msherman13/bixi/misc/bixi_pic2.JPG

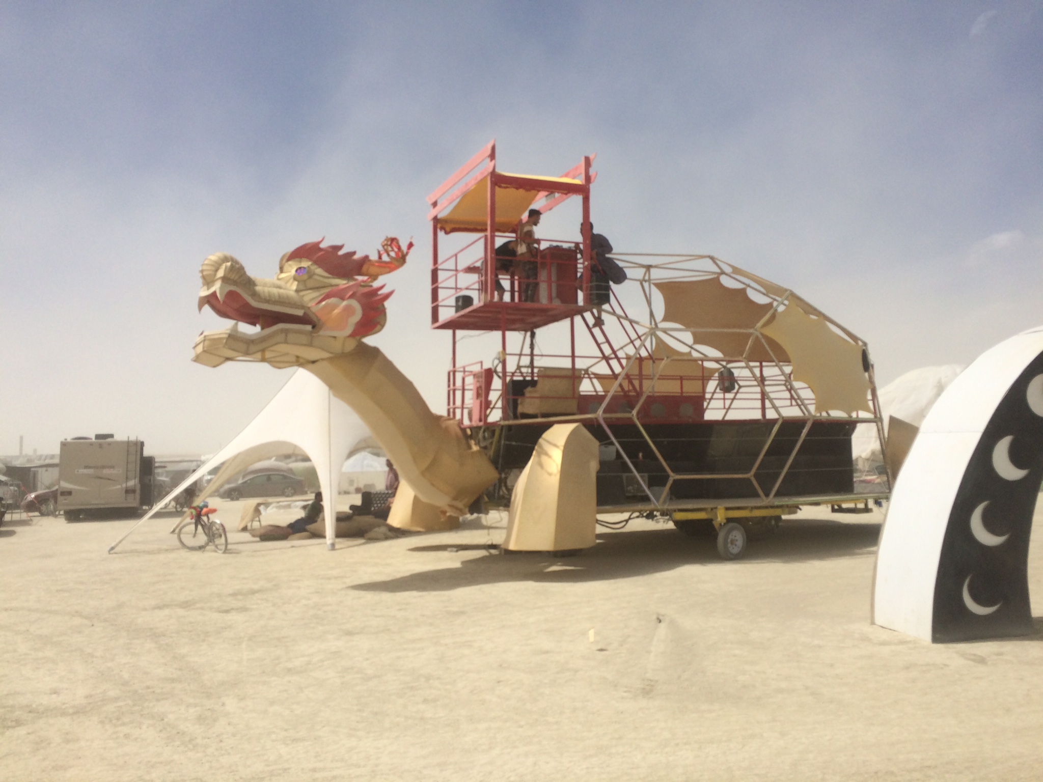
misc/bixi_pic2.JPG
