msherman13/bixi/misc/dimensions2.jpeg

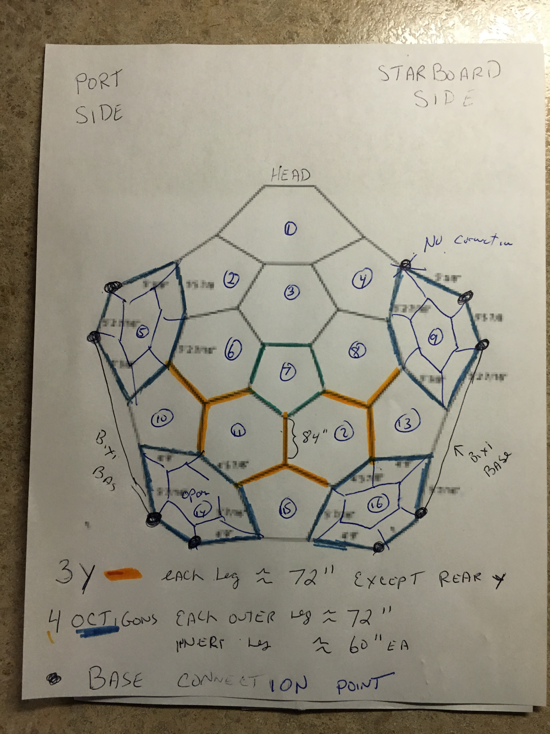
misc/dimensions2.jpeg
