msherman13/bixi/misc/bixi_dome_data_map.pdf

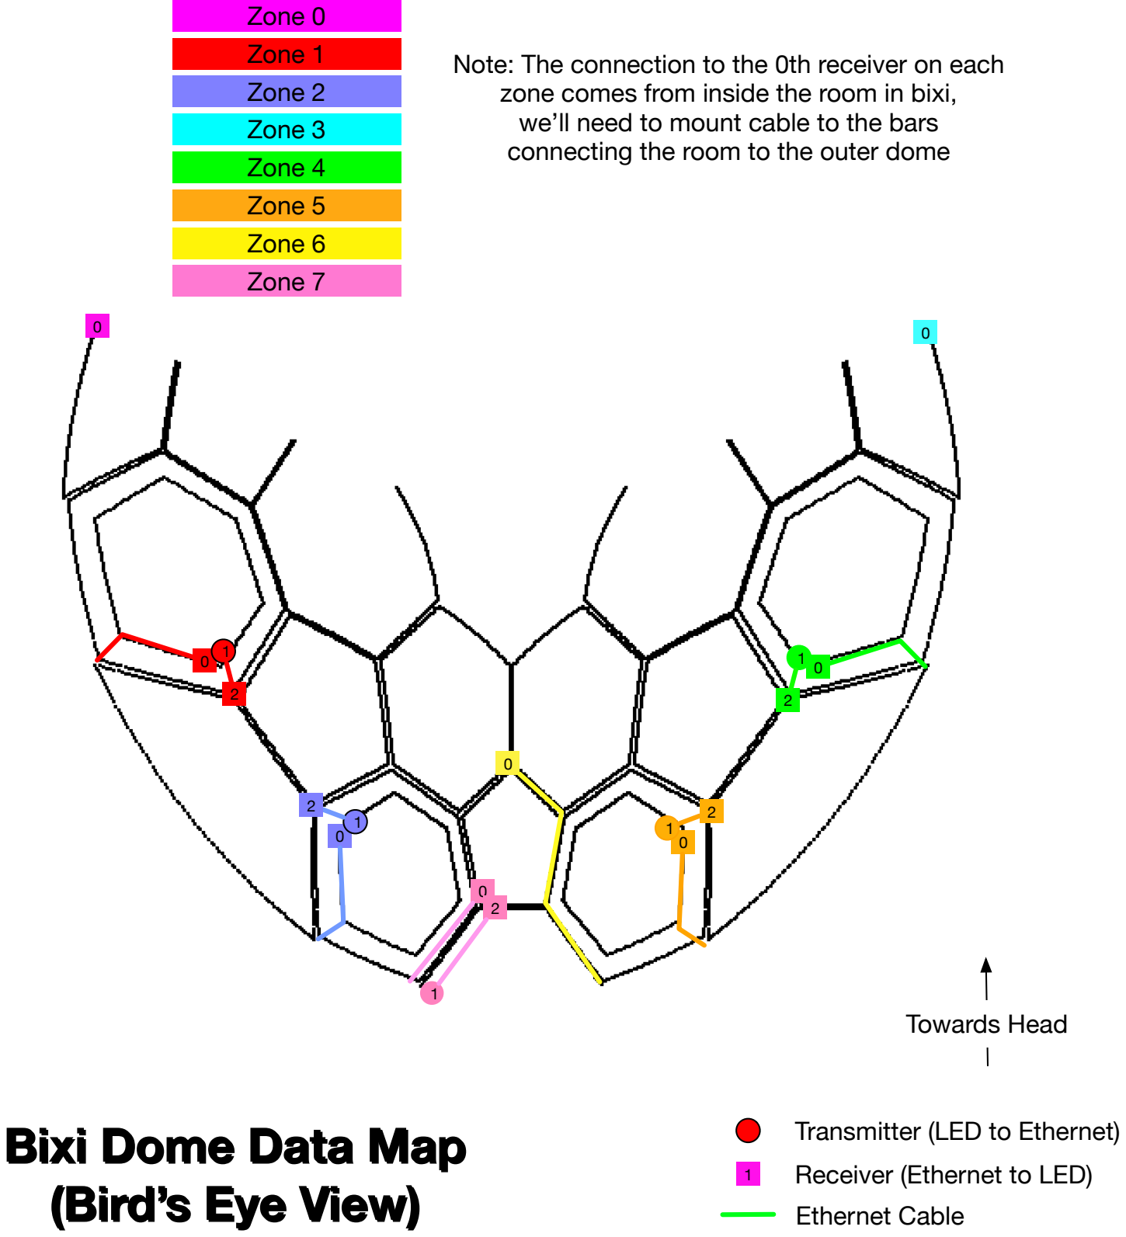
[picture p3: page 1]

Towards Head

Zone 0

1 Receiver (Ethernet to LED) Ethernet Cable

0

0

Note: The connection to the 0th receiver on each zone comes from inside the room in bixi, we’ll need to mount cable to the bars connecting the room to the outer dome

1

Transmitter (LED to Ethernet)

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
Zone 1
Zone 2
Zone 3
Zone 4
Zone 5
Zone 6
Zone 7

# Bixi Dome Data Map (Bird’s Eye View)

# Bixi Dome Data Map (Bird’s Eye View)
