msherman13/bixi/misc/bixi_dome_power_map.pdf

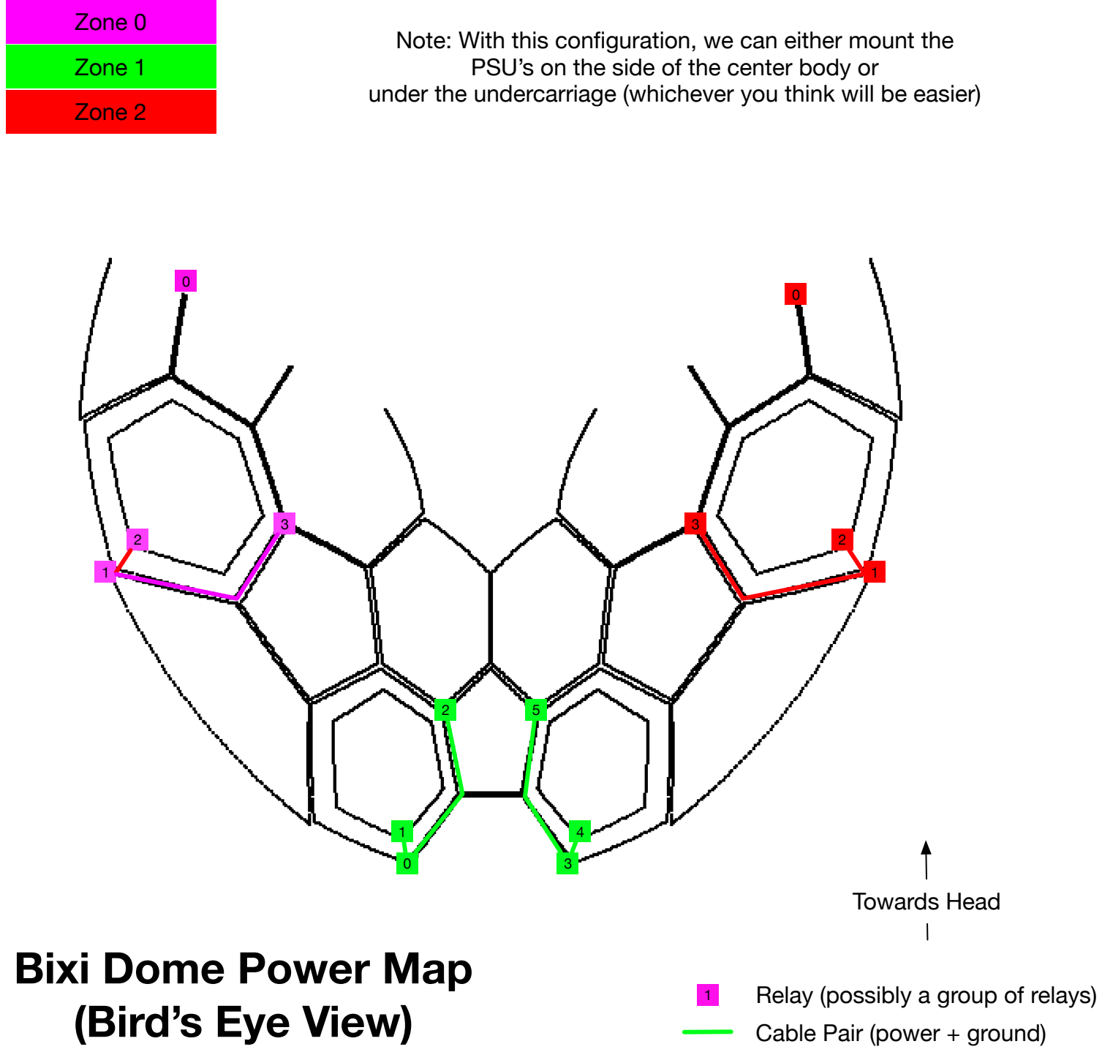
[picture p4: page 1]

Towards Head

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
Zone 0
Zone 1
Zone 2

Note: With this configuration, we can either mount the PSU’s on the side of the center body or under the undercarriage (whichever you think will be easier)

1 Relay (possibly a group of relays) Cable Pair (power + ground)

# Bixi Dome Power Map (Bird’s Eye View)
