msherman13/bixi/misc/bixi_dome_shape_map.pdf

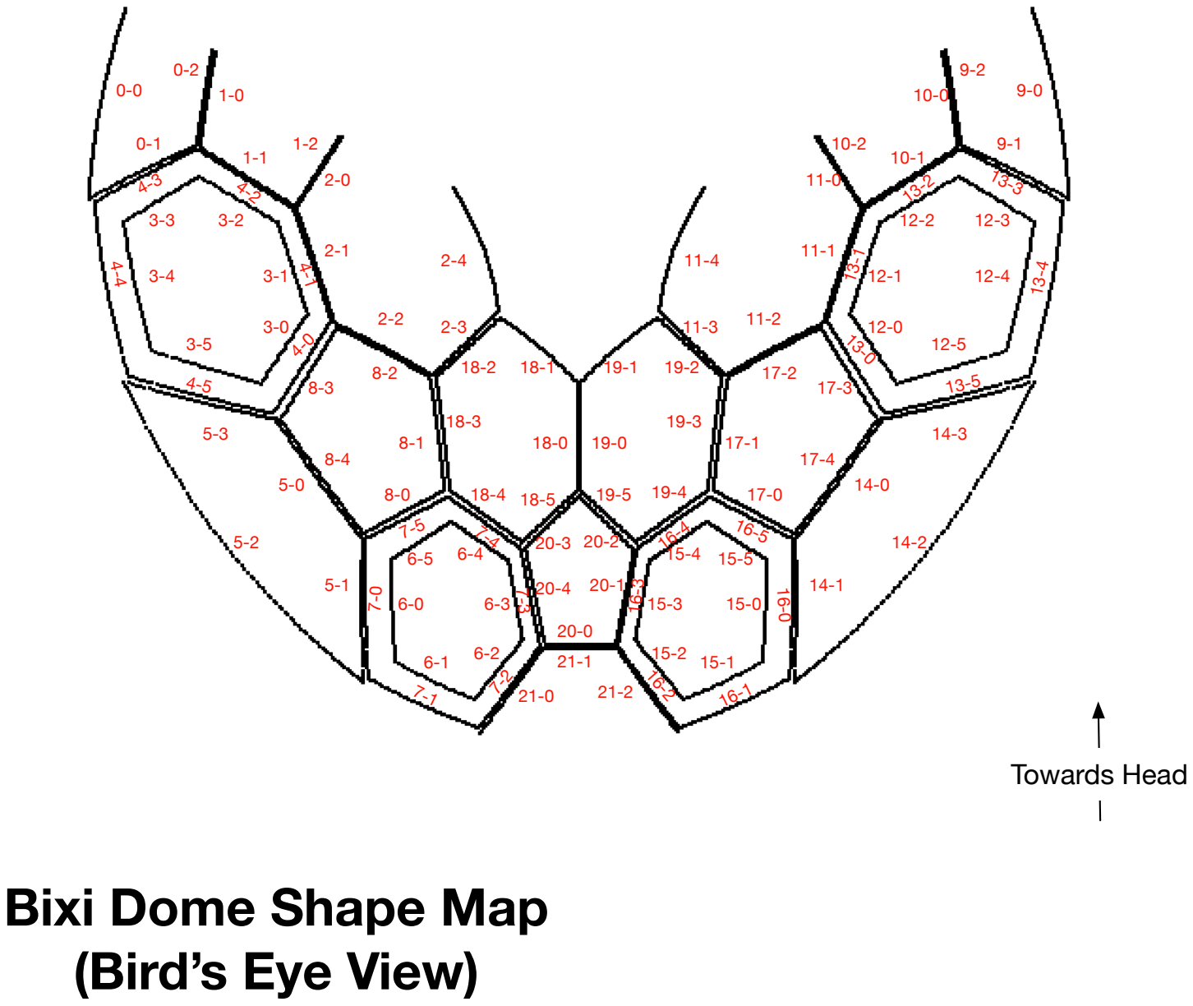
[picture p5: page 1]

## Towards Head

# Bixi Dome Shape Map (Bird’s Eye View)

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
2-2 2-3 2-4

3-0

3-1

3-3 3-2

3-4

3-5 | 4-0 4-1

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
6-1 6-2 6-3

6-4 6-5

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
10-0

10-1

10-2

11-0

11-1

11-2 11-3

11-4

12-0

12-1

12-2 | 12-3
| 12-4

12-5 13-0

13-1

13-2

13-3

13-4

13-5

14-0

14-1

14-2

14-3

15-0

15-1 15-2

15-3

15-4 15-5

16-0

16-1

16-2

16-3

16-4

16-5

17-0

17-1

17-2
17-3

17-4

18-0

18-2 18-1

18-3

18-4 18-5

19-0

19-1 | 19-2
| 19-3

19-5 19-4

20-0

20-1

20-3 20-2

20-4

21-0

21-1
21-2
