msherman13/bixi/misc/bixi_dome_shape_map.graffle/image2.png

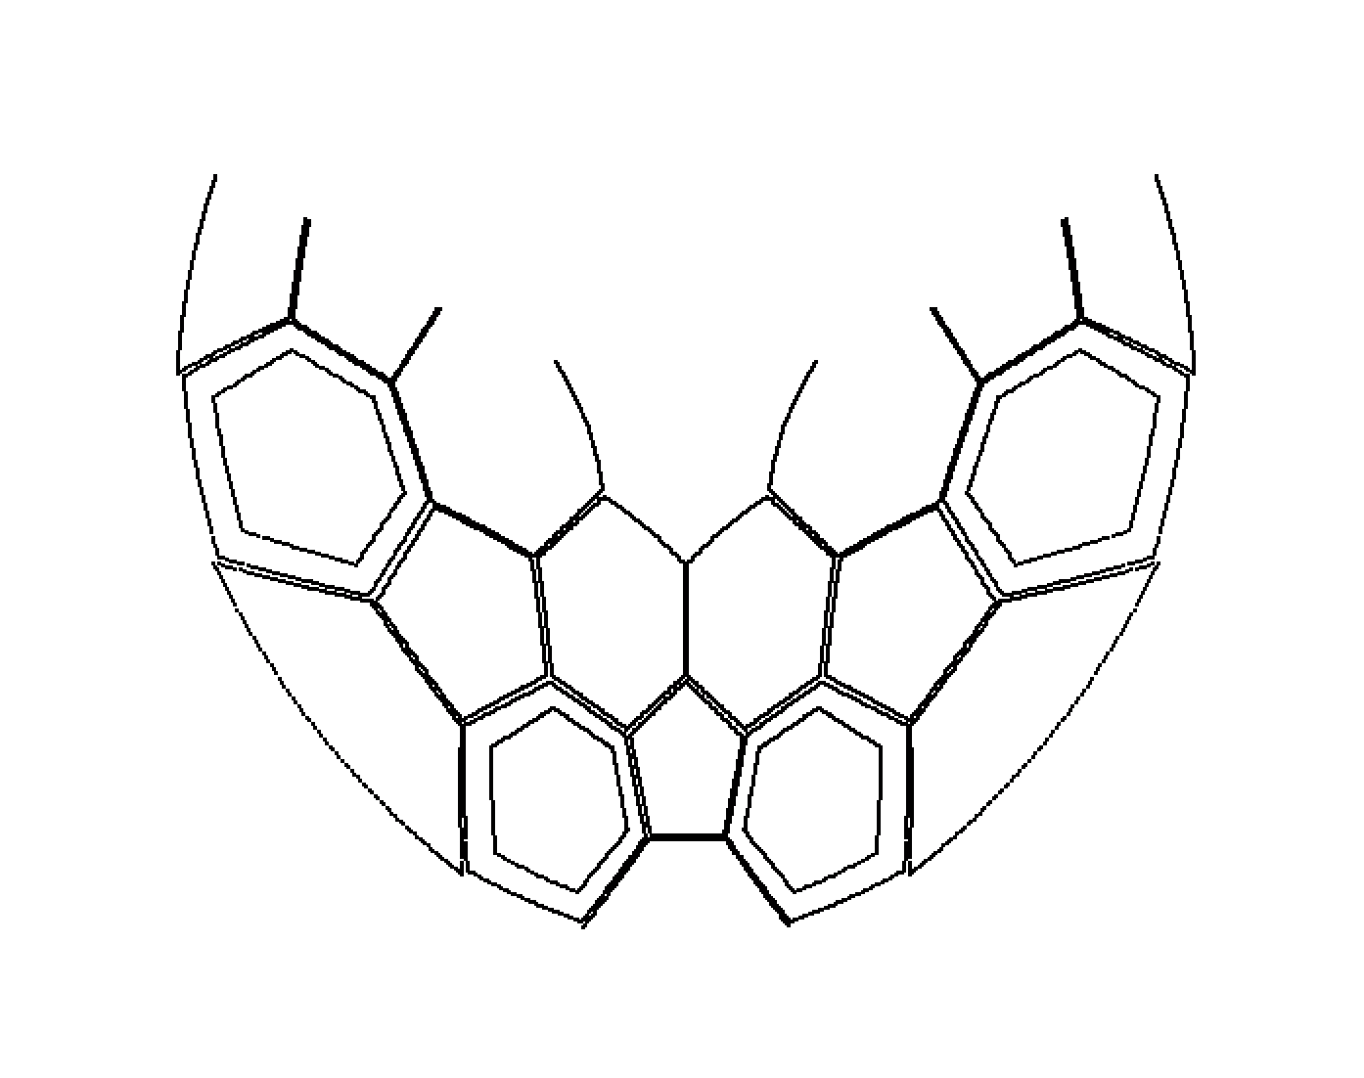
misc/bixi_dome_shape_map.graffle/image2.png
