msherman13/bixi/misc/bixi_led_indices.png

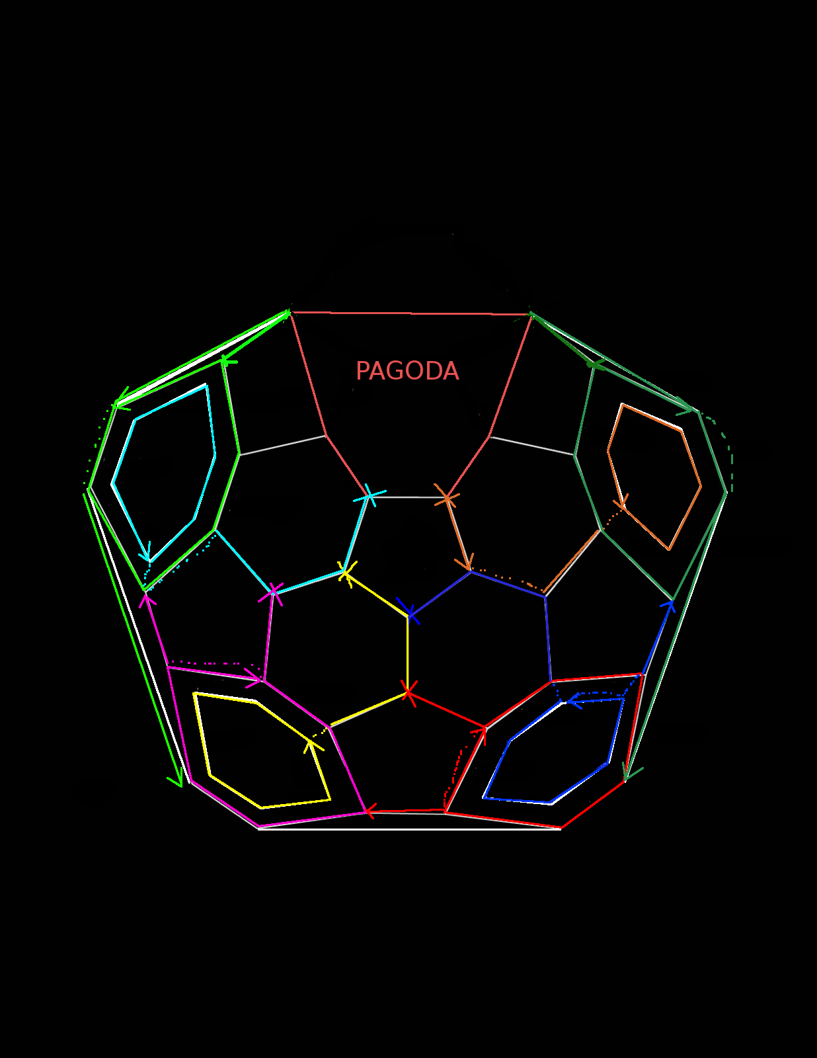
misc/bixi_led_indices.png
