msherman13/bixi/misc/bixi_outline.jpeg

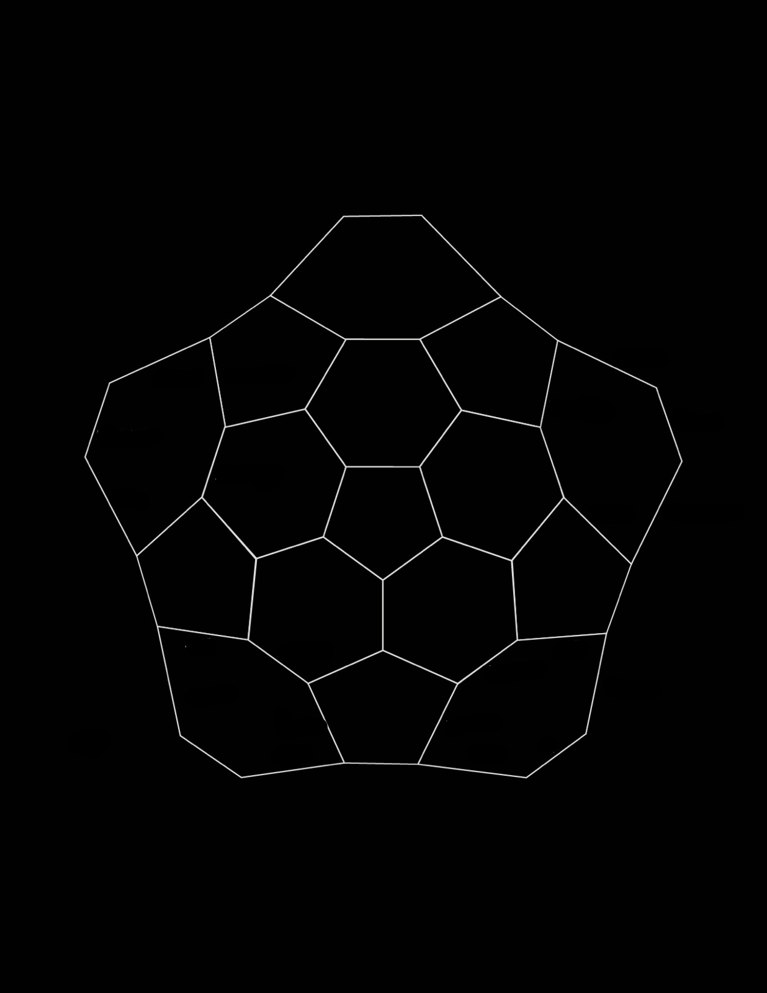
misc/bixi_outline.jpeg
