msherman13/bixi/misc/bixi_pic1.JPG

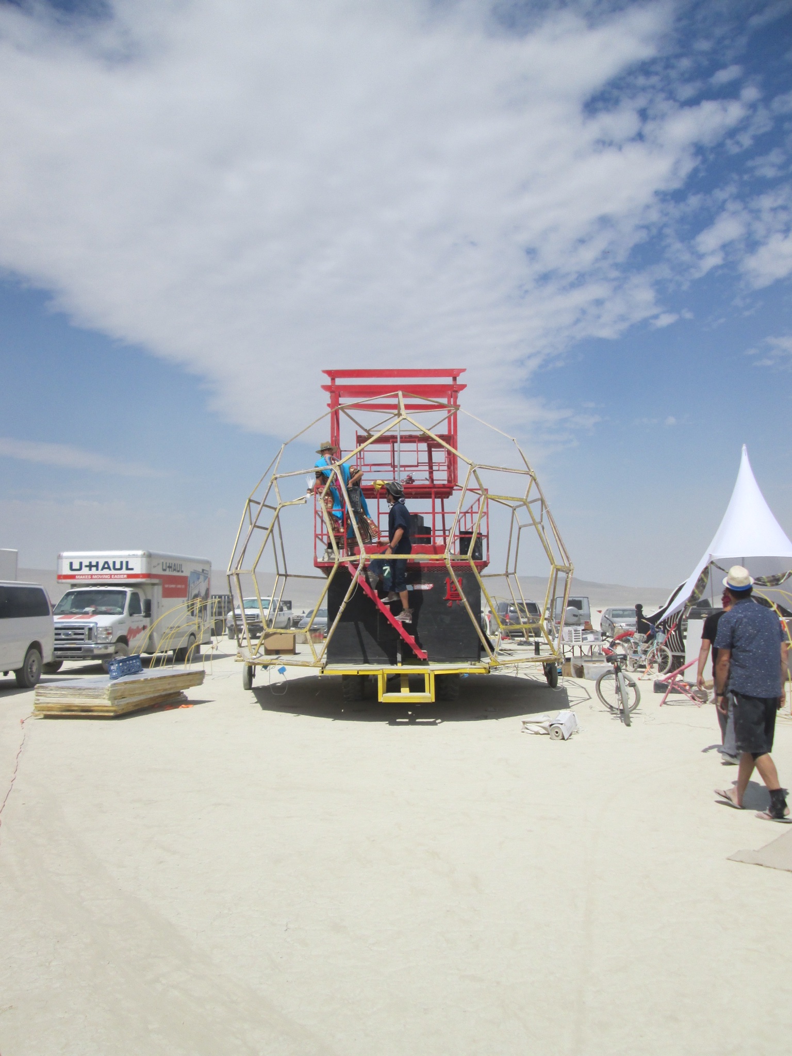
misc/bixi_pic1.JPG
