msherman13/bixi/misc/inventory.xlsx

Table 1
Item | Requirement | On Hand | At Jon’s | At Chris’s | Needed
LED’s | 450 | 300 | 0 | 150 | 0
Power Relay | 60 | 58 | 0 | 0 | 2
Power Relay Enclosure | 60 | 40 | 25 | 0 | -5
Receivers | 29 | 50 | 0 | 0 | -21
Transmitters | 5 | 10 | 0 | 0 | -5
Data Relay Enclosures | 34 | 80 | 0 | 0 | -46
Controllers | 3 | 6 | 0 | 0 | -3
Controller Enclosures | 3 | 1 | 2 | 0 | 0
PSU | 6 | 3 | 3 | 0 | 0
DC Power Cable | 300 | 50 | 250 | 0 | 0
AC Power Cable | 6 | 6 | 0 | 0 | 0
Controller PSU | 3 | 0 | 3 | 0 | 0
50ft Ethernet Cable | 24 | 8 | 16 | 0 | 0
18in Ethernet Cable | 4 | 8 | 0 | 0 | -4
5ft ethernet cable | 1 | 0 | 5 | 0 | -4
Power Relay Screws | 120 | 80 | 0 | 0 | 40
Power Strip | 2 | 0 | 0 | 0 | 2
