msherman13/bixi/(list of files, drawings)

Other design files:
kicad/bixi.dsn
kicad/bixi_node/bixi_node.dsn
kicad/sn75lbc175n_breakout/sn75lbc175n_breakout.dsn
