msherman13/bixi/kicad/bixi_node/bixi_node.kicad_pcb

## KiCad design kicad/bixi_node/bixi_node.kicad_pcb (2017-06-03)

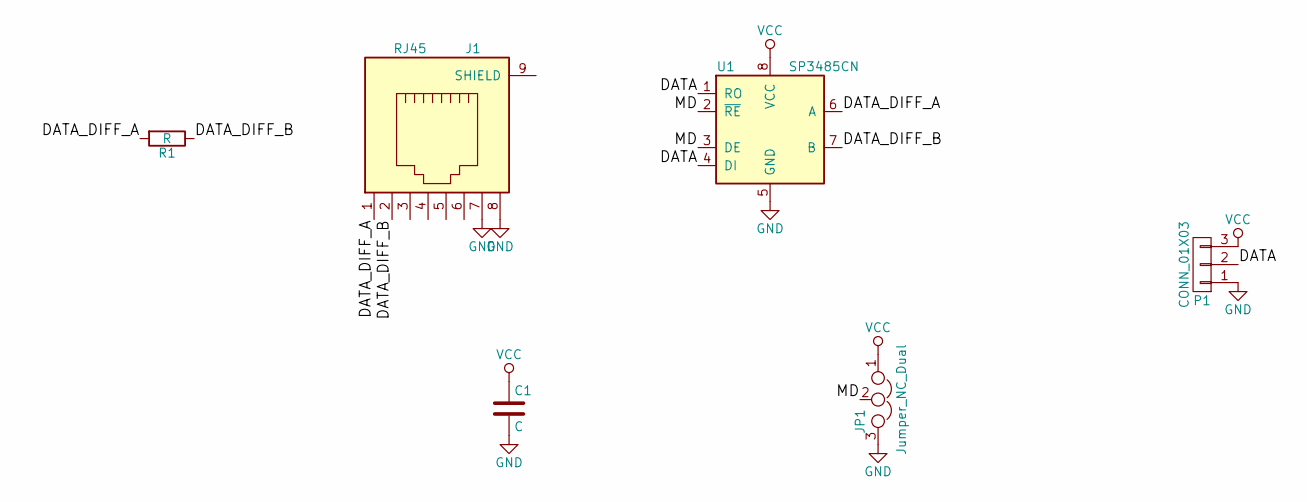
[picture p10: schematic bixi_node.sch]

Parts:
C1: C; C_Axial_L3.8mm_D2.6mm_P7.50mm_Horizontal
J1: RJ45; RJ45_8
JP1: Jumper_NC_Dual; jumper_3_pin_fixed
P1: CONN_01X03; 3-wire-hole-with-relief
R1: R; Resistor_Horizontal_RM7mm
U1: SP3485CN; DIP-8_W7.62mm

Connections:
/DATA: P1.2, U1.1 (RO), U1.4 (DI)
/DATA_DIFF_A: J1.1, R1.2, U1.6 (A)
/DATA_DIFF_B: J1.2, R1.1, U1.7 (B)
/MD: JP1.2, U1.2 (~RE~), U1.3 (DE)
GND: C1.2, J1.7, J1.8, JP1.3, P1.1, U1.5 (GND)
VCC: C1.1, JP1.1, P1.3, U1.8 (VCC)

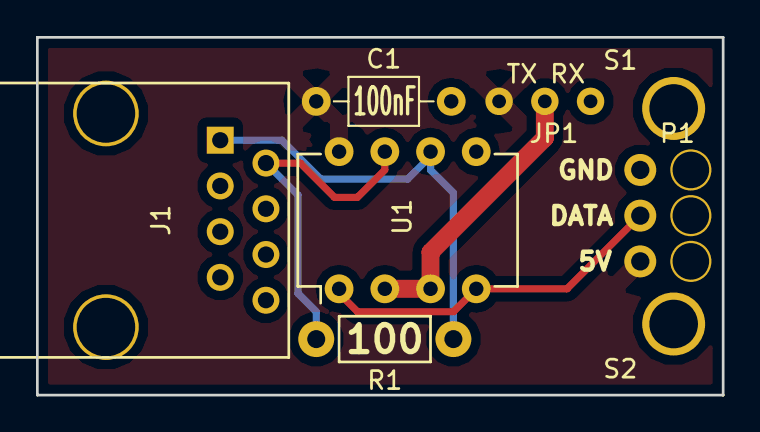
[picture p11: board bixi_node.kicad_pcb from above]

Board: 2 copper layers, 38.1 x 19.9 mm, 8 parts (0 on the bottom side), 6 nets.

Other parts of the board:
S1, S2: MountingHole_2.7mm_Pad
