msherman13/bixi/kicad/bixi_pt/bixi_pt.kicad_pcb

## KiCad design kicad/bixi_pt/bixi_pt.kicad_pcb (2017-05-24)

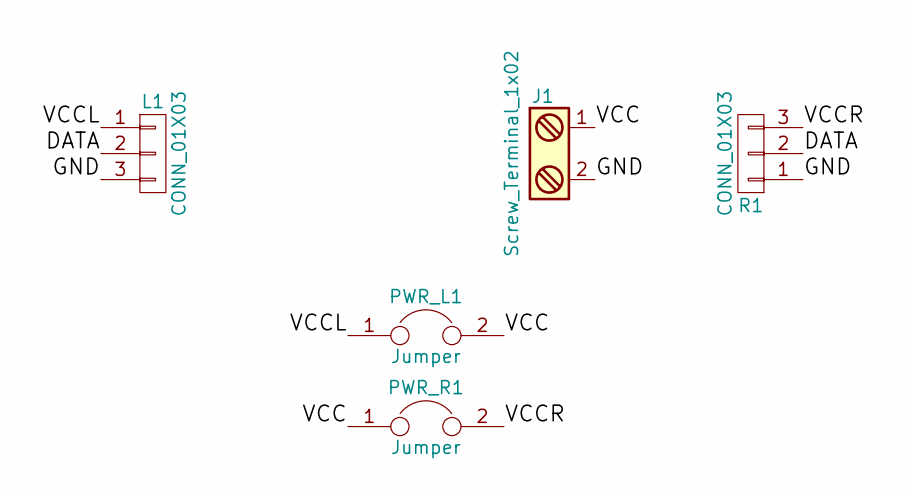
[picture p12: schematic bixi_pt.sch]

Parts:
J1: Screw_Terminal_1x02; OSTYK42102030-2P-Terminal
L1: CONN_01X03; 3-wire-hole-with-relief
PWR_L1: Jumper; Pin_Header_Straight_1x02_Pitch2.54mm
PWR_R1: Jumper; Pin_Header_Straight_1x02_Pitch2.54mm
R1: CONN_01X03; 3-wire-hole-with-relief

Connections:
/DATA: L1.2, R1.2
/GND: J1.2, L1.3, R1.1
/VCC: J1.1, PWR_L1.2, PWR_R1.1
/VCCL: L1.1, PWR_L1.1
/VCCR: PWR_R1.2, R1.3

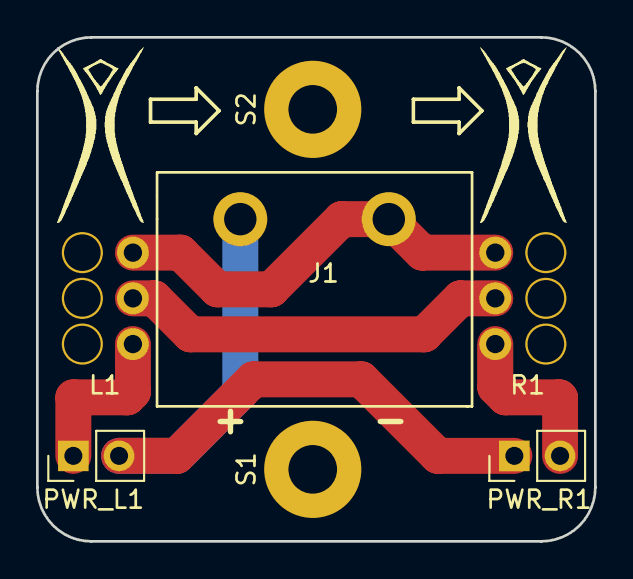
[picture p13: board bixi_pt.kicad_pcb from above]

Board: 2 copper layers, 31.0 x 28.0 mm, 9 parts (0 on the bottom side), 5 nets.

Other parts of the board:
S1, S2: MountingHole_3.5mm; MountingHole_2.7mm_Pad
burner-logo: burner-logo-fs
burner-logo#2: burner-logo-fs
