msherman13/bixi/kicad/sn75lbc175n_breakout/sn75lbc175n_breakout.kicad_pcb

## KiCad design kicad/sn75lbc175n_breakout/sn75lbc175n_breakout.kicad_pcb (2017-05-02)

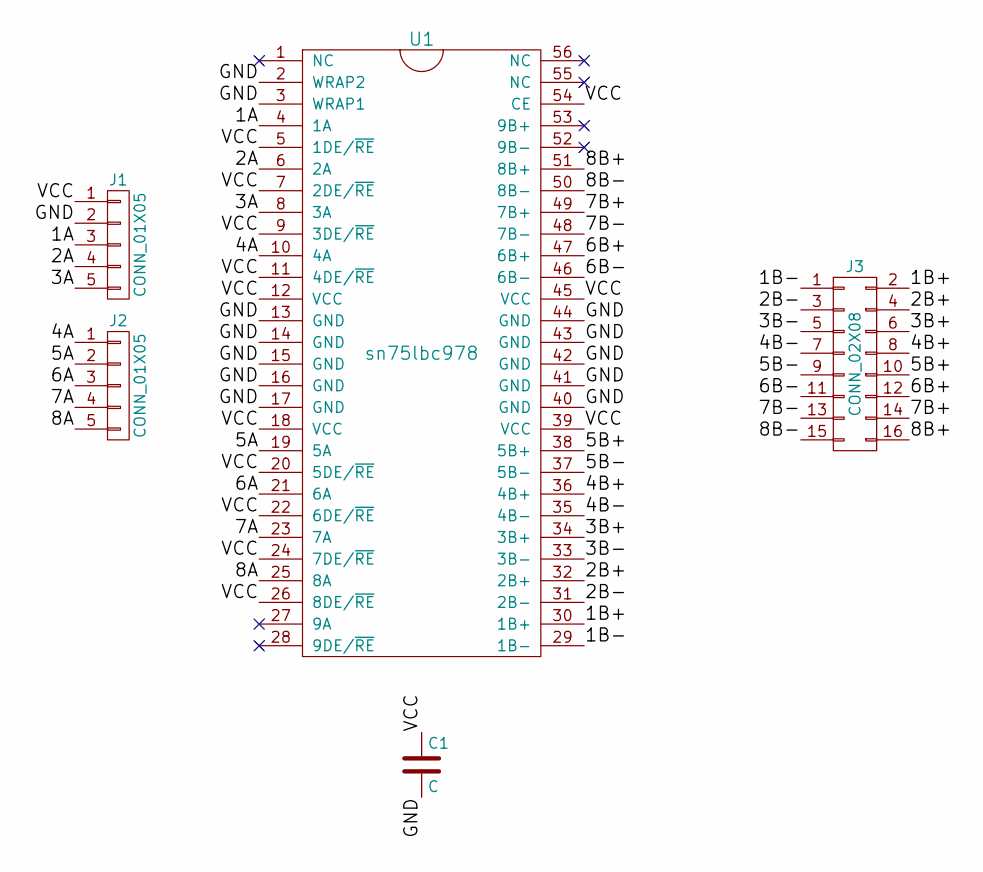
[picture p14: schematic sn75lbc175n_breakout.sch]

Parts:
C1: C; C_Disc_D4.7mm_W2.5mm_P5.00mm
J1, J2: CONN_01X05; Pin_Header_Straight_1x05_Pitch2.54mm
J3: CONN_02X08; Pin_Header_Straight_2x08_Pitch2.54mm
U1: sn75lbc978; SSOP-56_7.5x18.5mm_Pitch0.635mm

Connections:
/1A: J1.3, U1.4 (1A)
/1B+: J3.2, U1.30 (1B+)
/1B-: J3.1, U1.29 (1B-)
/2A: J1.4, U1.6 (2A)
/2B+: J3.4, U1.32 (2B+)
/2B-: J3.3, U1.31 (2B-)
/3A: J1.5, U1.8 (3A)
/3B+: J3.6, U1.34 (3B+)
/3B-: J3.5, U1.33 (3B-)
/4A: J2.1, U1.10 (4A)
/4B+: J3.8, U1.36 (4B+)
/4B-: J3.7, U1.35 (4B-)
/5A: J2.2, U1.19 (5A)
/5B+: J3.10, U1.38 (5B+)
/5B-: J3.9, U1.37 (5B-)
/6A: J2.3, U1.21 (6A)
/6B+: J3.12, U1.47 (6B+)
/6B-: J3.11, U1.46 (6B-)
/7A: J2.4, U1.23 (7A)
/7B+: J3.14, U1.49 (7B+)
/7B-: J3.13, U1.48 (7B-)
/8A: J2.5, U1.25 (8A)
/8B+: J3.16, U1.51 (8B+)
/8B-: J3.15, U1.50 (8B-)
/GND: C1.2, J1.2, U1.2 (WRAP2), U1.3 (WRAP1), U1.13 (GND), U1.14 (GND), U1.15 (GND), U1.16 (GND), U1.17 (GND), U1.40 (GND), U1.41 (GND), U1.42 (GND), U1.43 (GND), U1.44 (GND)
/VCC: C1.1, J1.1, U1.5 (1DE/~RE), U1.7 (2DE/~RE), U1.9 (3DE/~RE), U1.11 (4DE/~RE), U1.12 (VCC), U1.18 (VCC), U1.20 (5DE/~RE), U1.22 (6DE/~RE), U1.24 (7DE/~RE), U1.26 (8DE/~RE), U1.39 (VCC), U1.45 (VCC), U1.54 (CE)

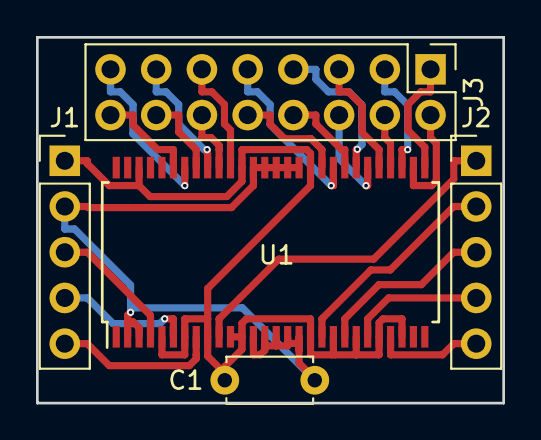
[picture p15: board sn75lbc175n_breakout.kicad_pcb from above]

Board: 2 copper layers, 25.9 x 20.3 mm, 5 parts (0 on the bottom side), 26 nets.
