msherman13/bixi/kicad/bixi.kicad_pcb

## KiCad design kicad/bixi.kicad_pcb (2017-04-09)

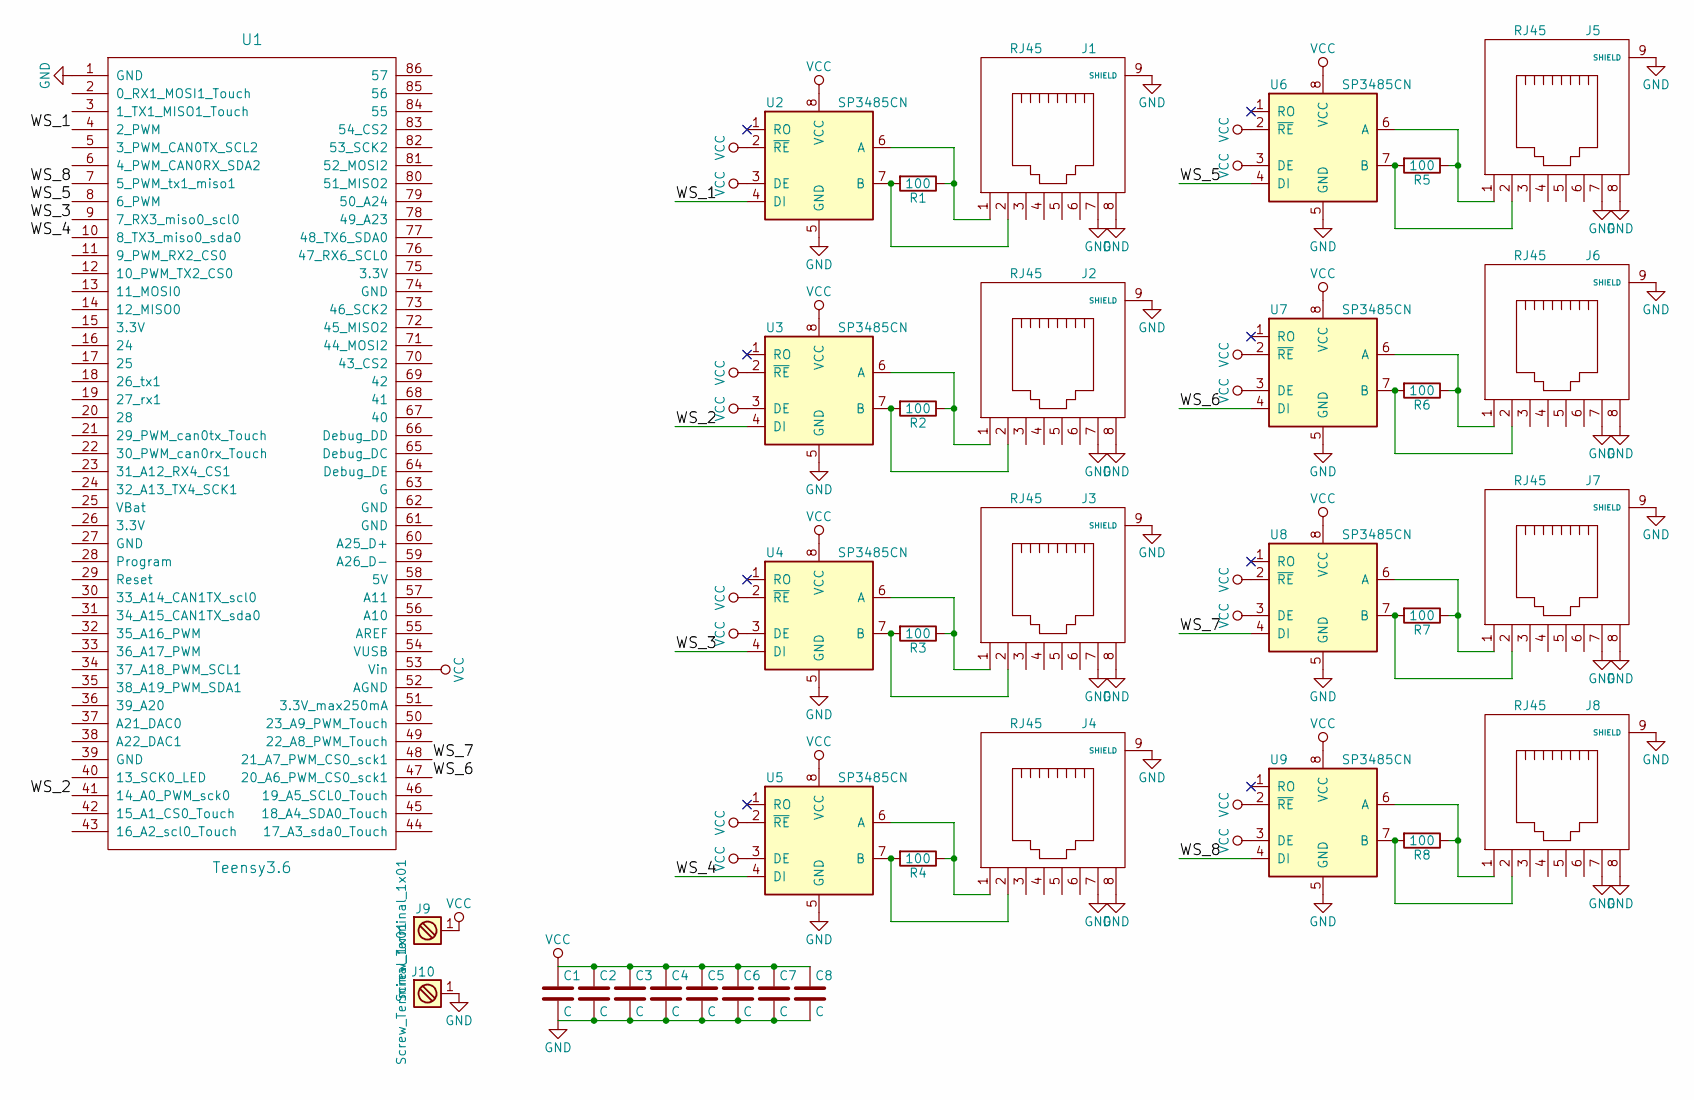
[picture p16: schematic bixi.sch]

Parts:
C1, C2, C3, C4, C5, C6, C7, C8: C; C_Disc_D3_P2.5
J1, J2, J3, J4, J5, J6, J7, J8: RJ45; RJ45_8
J9, J10: Screw_Terminal_1x01; A116169CT_SPADE_CONNECTOR
R1, R2, R3, R4, R5, R6, R7, R8: 100; Resistor_Horizontal_RM7mm
U1: Teensy3.6; Teensy35_36
U2, U3, U4, U5, U6, U7, U8, U9: SP3485CN; DIP-8_W7.62mm

Connections:
/WS_1: U1.4 (2_PWM), U2.4 (DI)
/WS_2: U1.41 (14_A0_PWM_sck0), U3.4 (DI)
/WS_3: U1.9 (7_RX3_miso0_scl0), U4.4 (DI)
/WS_4: U1.10 (8_TX3_miso0_sda0), U5.4 (DI)
/WS_5: U1.8 (6_PWM), U6.4 (DI)
/WS_6: U1.47 (20_A6_PWM_CS0_sck1), U7.4 (DI)
/WS_7: U1.48 (21_A7_PWM_CS0_sck1), U8.4 (DI)
/WS_8: U1.7 (5_PWM_tx1_miso1), U9.4 (DI)
GND: C1.2, C2.2, C3.2, C4.2, C5.2, C6.2, C7.2, C8.2, J1.7, J1.8, J1.9 (SHIELD), J2.7, J2.8, J2.9 (SHIELD), J3.7, J3.8, J3.9 (SHIELD), J4.7, J4.8, J4.9 (SHIELD), J5.7, J5.8, J5.9 (SHIELD), J6.7, J6.8, J6.9 (SHIELD), J7.7, J7.8, J7.9 (SHIELD), J8.7, J8.8, J8.9 (SHIELD), J10.1, U1.1 (GND), U2.5 (GND), U3.5 (GND), U4.5 (GND), U5.5 (GND), U6.5 (GND), U7.5 (GND), U8.5 (GND), U9.5 (GND)
unnamed: J1.1, R1.1, U2.6 (A)
unnamed: J1.2, R1.2, U2.7 (B)
unnamed: J2.1, R2.1, U3.6 (A)
unnamed: J2.2, R2.2, U3.7 (B)
unnamed: J3.1, R3.1, U4.6 (A)
unnamed: J3.2, R3.2, U4.7 (B)
unnamed: J4.1, R4.1, U5.6 (A)
unnamed: J4.2, R4.2, U5.7 (B)
unnamed: J5.1, R5.1, U6.6 (A)
unnamed: J5.2, R5.2, U6.7 (B)
unnamed: J6.1, R6.1, U7.6 (A)
unnamed: J6.2, R6.2, U7.7 (B)
unnamed: J7.1, R7.1, U8.6 (A)
unnamed: J7.2, R7.2, U8.7 (B)
unnamed: J8.1, R8.1, U9.6 (A)
unnamed: J8.2, R8.2, U9.7 (B)
VCC: C1.1, C2.1, C3.1, C4.1, C5.1, C6.1, C7.1, C8.1, J9.1, U1.53 (Vin), U2.2 (~RE~), U2.3 (DE), U2.8 (VCC), U3.2 (~RE~), U3.3 (DE), U3.8 (VCC), U4.2 (~RE~), U4.3 (DE), U4.8 (VCC), U5.2 (~RE~), U5.3 (DE), U5.8 (VCC), U6.2 (~RE~), U6.3 (DE), U6.8 (VCC), U7.2 (~RE~), U7.3 (DE), U7.8 (VCC), U8.2 (~RE~), U8.3 (DE), U8.8 (VCC), U9.2 (~RE~), U9.3 (DE), U9.8 (VCC)

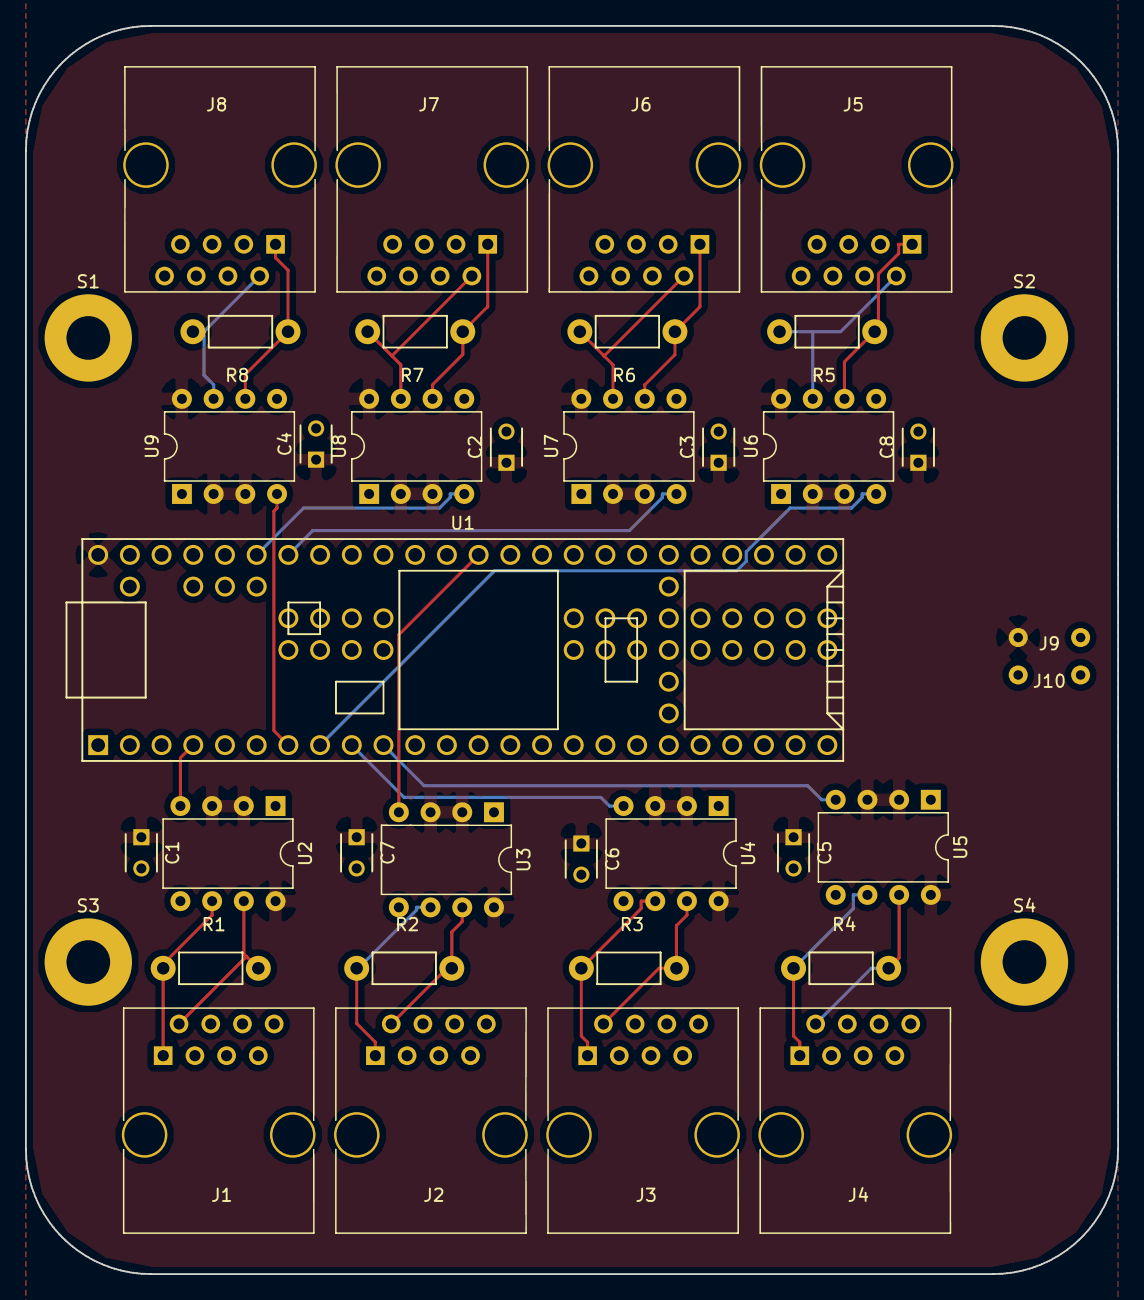
[picture p17: board bixi.kicad_pcb from above]

Board: 2 copper layers, 87.5 x 100.0 mm, 40 parts (0 on the bottom side), 26 nets.

Other parts of the board:
S1, S2, S3, S4: MountingHole_3.5mm_Pad
bm_streets: bm_streets
