msherman13/bixi/bixi.ino

#include "Bixi.h"
#include "Logging.h"

void setup()
{
    CLogging::Init();
    CBixi::Instance();
    CLogging::log("Bixi is initialized");
}

void loop()
{ 
    while(!CBixi::Instance().ShuttingDown())
    {
        CBixi::Instance().Continue();
    }
}  
