msherman13/bixi/RoutineBall.cpp

#include <algorithm>
#include <cmath>

#include "RoutineBall.h"
#include "ColorPallete.h"
#include "FastLED.h"
#include "Arduino.h"
#include "Math.h"

CMemoryPool<CRoutineBall, CRoutineBall::c_alloc_qty> CRoutineBall::s_pool;

CRoutineBall::CRoutineBall(CPixelArray* pixels,
                           size_t       q,
                           size_t       period_sec) :
    CRoutine(pixels),
    m_q(q),
    m_period_sec(period_sec)
{
    m_last_run = millis();

    m_radius = c_longest_distance * (1.00 - powf(14 / 255.0, 1.0 / m_q));
}

CRoutineBall::~CRoutineBall()
{
}

CPixelArray::Coordinate CRoutineBall::RecalculateMidpoint()
{
    size_t now = millis();

    if(m_ball_start == 0 || now - m_ball_start >= m_period_sec * 1000)
    {
        m_ball_start = now;

        size_t side = m_last_side;
        while(side == m_last_side)
        {
            side = rand() % 4;
        }

        m_midpoint.x = ((float)(rand() % 200) / 200) - 1.00;
        m_midpoint.y = ((float)(rand() % 200) / 200) - 1.00;

        m_x_step     = ((float)(rand() % 100) / 100) * 2 / (m_period_sec * 1000);
        m_y_step     = ((float)(rand() % 100) / 100) * 2 / (m_period_sec * 1000);

        switch(side)
        {
            case 0:
                m_midpoint.x = c_frame_size / 2;
                m_x_step     = (2 * -m_midpoint.x) / (m_period_sec * 1000);
                break;
            case 1:
                m_midpoint.x = -c_frame_size / 2;
                m_x_step     = (2 * -m_midpoint.x) / (m_period_sec * 1000);
                break;
            case 2:
                m_midpoint.y = c_frame_size / 2;
                m_y_step     = (2 * -m_midpoint.y) / (m_period_sec * 1000);
                break;
            case 3:
                m_midpoint.y = -c_frame_size / 2;
                m_y_step     = (2 * -m_midpoint.y) / (m_period_sec * 1000);
                break;
        }

        size_t color_index = m_color_index;
        while(color_index == m_color_index)
        {
            color_index = rand() % ColorPallete::Qty;
        }
        m_color_index = color_index;
        m_color = rgb2hsv_approximate(ColorPallete::s_colors[m_color_index]);

        m_last_side = side;
    }

    m_midpoint.x += (float)(now - m_last_run) * m_x_step;
    m_midpoint.y += (float)(now - m_last_run) * m_y_step;

    m_last_run = now;

    return m_midpoint;
}

CHSV CRoutineBall::RecalculateColor(size_t index)
{
    CHSV hsv = m_color;

    CPixelArray::Coordinate coord = GetCoordinate(index);

    float x_dist                 = fabs(m_midpoint.x - coord.x);
    float y_dist                 = fabs(m_midpoint.y - coord.y);

    // optimization to try and speed this up a bit
    if(x_dist > m_radius || y_dist > m_radius)
    {
        hsv.val = 0;
        return hsv;
    }

    float distance               = Math::fast_sqrt(powf(x_dist, 2) + powf(y_dist, 2)) / c_longest_distance;
    float brightness             = Math::exp_by_squaring(1 - distance, m_q);

    hsv.val = brightness * 255;

    return hsv;
}

void CRoutineBall::Continue()
{
    RecalculateMidpoint();

    for(size_t i=0;i<GetSize();i++)
    {
        CHSV hsv = RecalculateColor(i);
        SetPixel(i, hsv);
    }
}
