msherman13/bixi/RoutineFire.h

#ifdef GEOM_HEAD

#pragma once

#include "stdint.h"

#include "Routine.h"
#include "FastLED.h"

class CPixelArray;

class CRoutineFire : public CRoutine
{
    public:
        static constexpr size_t c_alloc_qty           = 8;
        static constexpr size_t c_num_colors          = 256;
        static constexpr int    c_x_pixels            = 1;
        static constexpr int    c_y_pixels            = 100;

    public:
        CRoutineFire(CPixelArray* pixels);
        ~CRoutineFire();

    public:
        virtual void        Continue() override;
        virtual const char* GetName()  override { return "Fire"; }

    private:
        void Init();

    private:
        CHSV   m_colors[c_num_colors];
        size_t m_fire[c_y_pixels][c_x_pixels] = {};
        size_t m_last_run = 0;

    private:
        static CMemoryPool<CRoutineFire, c_alloc_qty> s_pool;

    public:
        void* operator new(size_t)
        {
            return s_pool.alloc();
        }

        void operator delete(void* ptr)
        {
            s_pool.free(reinterpret_cast<CRoutineFire*>(ptr));
        }
};

#endif // GEOM_HEAD
