msherman13/bixi/RoutineBall.h

#pragma once

#include "stdint.h"

#include "Routine.h"
#include "FastLED.h"
#include "PixelArray.h"

class CRoutineBall : public CRoutine
{
    public:
        static constexpr size_t c_alloc_qty = 16;
        static constexpr float c_frame_size = 2.5;
        static constexpr float c_longest_distance = sqrtf(pow(c_frame_size, 2) + pow(c_frame_size, 2));

    public:
        CRoutineBall(CPixelArray* pixels,
                        size_t    q,
                        size_t    period_sec);
        ~CRoutineBall();

    public:
        virtual void        Continue() override;
        virtual const char* GetName()  override { return "Ball"; }

    private:
        void                    Init();

    public:
        CPixelArray::Coordinate RecalculateMidpoint();
        CHSV                    RecalculateColor(size_t index);

    private:
        CHSV                    m_color;
        size_t                  m_color_index  = 0;
        size_t                  m_q            = 0;
        float                   m_radius       = 0;
        size_t                m_period_sec   = 10;
        size_t                m_last_run     = 0;
        size_t                m_ball_start   = 0;
        size_t                  m_last_side    = 0;
        float                   m_x_step       = 0.0;
        float                   m_y_step       = 0.0;
        CPixelArray::Coordinate m_midpoint;

    private:
        static CMemoryPool<CRoutineBall, c_alloc_qty> s_pool;

    public:
        void* operator new(size_t)
        {
            return s_pool.alloc();
        }

        void operator delete(void* ptr)
        {
            s_pool.free(reinterpret_cast<CRoutineBall*>(ptr));
        }
};
