msherman13/bixi/(commit log)

2017-01-22 makefile, example neopixel driver
2017-02-12 initial routines working. out of memory on arduino nano
2017-03-04 style fixes, fix to HoldRainbow hue wraparound
    [Bixi.cpp, Bixi.h, Logging.cpp, Logging.h, Routine.cpp, Routine.h, RoutineSparkle.cpp, RoutineSparkle.h]
2017-03-04 fixed exitRoutine bug, removed debug logging
    [Bixi.cpp]
2017-03-18 initial kicad draft
    [bixi.kicad_pcb, bixi.sch]
2017-03-19 kicad schematic and layout
    [_saved_bixi_node.sch, bixi.dsn, bixi.kicad_pcb, bixi.sch, bixi_node.kicad_pcb, bixi_node.sch]
2017-03-19 updated controller layout
    [_saved_bixi_node.sch, bixi.kicad_pcb, bixi_node.sch]
2017-03-19 more controller layout changes
    [bixi.kicad_pcb]
2017-03-26 controller and receiver boards almost done for v1
    [bixi.kicad_pcb, bixi.sch, bixi_node.dsn, bixi_node.sch]
2017-04-02 controller board screw terminal, screw holes. ready for build
    [bixi.dsn, bixi.kicad_pcb, bixi.sch, bixi_node.kicad_pcb]
2017-04-02 keep-out area for terminal block, finalized node pcb
    [bixi.kicad_pcb, bixi_node.dsn, bixi_node.kicad_pcb, bixi_node.sch]
2017-04-02 larger pads on screw terminal connector
    [bixi.kicad_pcb, bixi_node.kicad_pcb]
2017-04-09 both pcb's sent to fab
    [bixi-B.Cu.gbl, bixi-B.Mask.gbs, bixi-Edge.Cuts.gm1, bixi-F.Cu.gtl, bixi-F.Mask.gts, bixi-F.SilkS.gto, bixi-NPTH.drl, bixi.drl]
2017-04-09 fix to silkscreen placement on bixi pcb
    [bixi.kicad_pcb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]
2017-04-25 v2 pcb
    [bixi-B.Cu.gbl, bixi-B.Mask.gbs, bixi-Edge.Cuts.gm1, bixi-F.Cu.gtl, bixi-F.Mask.gts, bixi-F.SilkS.gto, bixi.drl, bixi_node-B.Cu.gbl]
2017-04-29 bixi node updates
    [bixi.sch, bixi_node.dsn, bixi_node.kicad_pcb, bixi_node.sch]
2017-04-30 v3 pcb first pass
    [bixi.dsn, bixi.sch]
2017-04-30 initial work on laying out the LED's on the frame
    [bixi_led_indices.csv, bixi_led_indices.ods]
2017-05-02 v3 boards almost complete. added xcvr breakout, passthrough boards
    [bixi-B.Cu.gbl, bixi-B.Mask.gbs, bixi-Edge.Cuts.gm1, bixi-F.Cu.gtl, bixi-F.Mask.gts, bixi-F.SilkS.gto, bixi-NPTH.drl, bixi.drl]
2017-05-04 v3 pcb's plotted, ready for fab
    [bixi-B.Cu.gbl, bixi-B.Mask.gbs, bixi-Edge.Cuts.gm1, bixi-F.Cu.gtl, bixi-F.Mask.gts, bixi-F.SilkS.gto, bixi_node-B.Cu.gbl, bixi_node-B.Mask.gbs]
2017-05-06 indices changes
    [bixi_led_indices.csv, bixi_led_indices.ods]
2017-05-12 first changes for v4 pcb's
    [bixi-B.Cu.gbl, bixi-B.Mask.gbs, bixi-Edge.Cuts.gm1, bixi-F.Cu.gtl, bixi-F.Mask.gts, bixi-F.SilkS.gto, bixi-NPTH.drl, bixi.drl]
2017-05-12 remove std::string (not supported by arduino)
2017-05-16 FastLED: Fix issue with driver on short strands
    [Bixi.cpp, Bixi.h]
2017-05-17 dimensions2, first hex routine
    [dimensions2.xlsx]
2017-05-21 new power injection board is ready
    [bixi_pt-B.Cu.gbl, bixi_pt-B.Mask.gbs, bixi_pt-B.SilkS.gbo, bixi_pt-Edge.Cuts.gm1, bixi_pt-F.Cu.gtl, bixi_pt-F.Mask.gts, bixi_pt-NPTH.drl, bixi_pt.drl]
2017-05-21 new controller board
    [bixi-B.Cu.gbl, bixi-B.Mask.gbs, bixi-Edge.Cuts.gm1, bixi-F.Cu.gtl, bixi-F.Mask.gts, bixi-F.SilkS.gto, bixi-NPTH.drl, bixi.drl]
2017-05-21 fixes to boards, node still in progress
    [bixi.dsn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]
2017-05-22 CDome, fixes to swipe routine
    [Bixi.cpp, Bixi.h, Dome.cpp, Dome.h, PixelArray.cpp, PixelArray.h, Routine2dSwipe.cpp, Routine2dSwipe.h]
2017-05-23 updated controller board with stacked rj45
    [bixi-B.Cu.gbl, bixi-B.Mask.gbs, bixi-Edge.Cuts.gm1, bixi-F.Cu.gtl, bixi-F.Mask.gts, bixi-F.SilkS.gto, bixi-NPTH.drl, bixi.drl]
2017-05-23 re-plotted controller board after DRC
    [bixi-B.Cu.gbl, bixi-B.Mask.gbs, bixi-Edge.Cuts.gm1, bixi-F.Cu.gtl, bixi-F.Mask.gts, bixi-F.SilkS.gto]
2017-05-24 node work for keystone box
    [bixi_node.kicad_pcb, bixi_node.sch]
2017-05-24 final v4 pcb's, sent to production
    [bixi-B.Cu.gbl, bixi-B.Mask.gbs, bixi-Edge.Cuts.gm1, bixi-F.Cu.gtl, bixi-F.Mask.gts, bixi-F.SilkS.gto, bixi-NPTH.drl, bixi.drl]
2017-06-03 fix a bug introduced in the previous commit
    [Bixi.cpp, Bixi.h, Dome.cpp, Logging.cpp, PixelArray.cpp, bixi.ino]
2017-06-03 more bug fixes, fixed memory leak
    [Bixi.cpp, Bixi.h, ColorPallete.h, Dome.cpp, Dome.h, PixelArray.cpp]
2017-06-05 fixed the memory allocation nightmare. everything statically allocated
    [Bixi.cpp, Dome.cpp, Dome.h, DomeMappings.h, FreeRam.h, Grid.cpp, Grid.h, GridMappings.h]
2017-06-06 Split out pixel array with legs to derived class
2017-06-06 fixup of dome for shutdown routine
    [Dome.cpp, Dome.h, PixelArrayLegs.cpp, RoutineBall.cpp]
2017-06-06 fix to dome, routineBall shutdown
    [Dome.cpp, Dome.h, PixelArray.h, PixelArrayLegs.cpp, RoutineBall.cpp]
2017-06-11 fix include in balls
    [Dome.cpp, RoutineBalls.h]
2017-06-11 rough dimensions for dome, generation scripts
    [3d_corners.csv, geog_corners.csv]
2017-06-11 fixes for refresh rate, addressing issue
    [Bixi.cpp, Dome.cpp, Math.cpp, Math.h, PixelArray.cpp, RoutineBall.cpp, RoutineBalls.h]
2017-06-11 make Dome leg-based
2017-06-15 everything working except make issue with teensy
    [3d_corners.csv, geog_corners.csv]
2017-06-16 new layout, routine-spin, fixed point math
    [3d_corners.csv, geog_corners.csv]
2017-06-20 new dimensions from sketchup, mapprojection is broken
    [3d_corners_from_sketchup.csv]
2017-06-21 fixed lambert projection (was using std::abs instead of fabs)
    [3d_corners_from_sketchup.csv]
2017-06-21 OCTO2813 dma
2017-06-24 dome and power maps
2017-06-24 dome and power map pdf's
2017-06-25 fixed arduino make
2017-06-25 fire is still kinda broken`
    [RoutineFire.cpp]
2017-06-27 some work on color correction
    [Bixi.cpp, ColorPallete.h, Head.cpp, HeadMappings.h, PixelArray.h, RoutineFire.cpp, RoutineFire.h]
2017-07-15 add 3 led's to every dome dimension
    [3d_corners_from_sketchup.csv]
2017-07-19 bug fix in 3d_locations_from_sketchup file
    [3d_corners_from_sketchup.csv]
2017-07-19 turn off gamma correction, fix issue with uninitialized CRGB values
    [Bixi.cpp, RoutineRings.cpp]
2017-07-20 fix a bug which allows Dome to go into RoutineIdle
    [Dome.h]
2017-07-20 fix for Math::fast_pow which caused nan to be returned
    [Math.cpp]
2017-07-23 rename dome mappings csv
    [dome_mappings.csv]
2017-07-23 move file
    [dome_mappings.csv]
2017-07-23 automate legs and neck mapping
    [legs_and_neck_mappings.csv]
2017-07-23 Head mappings now automated
    [head_mappings.csv]
2017-07-23 dome shape map, inventory spreadsheet
    [inventory.xlsx]
2017-07-29 bugfix in leg mappings, traversenose routine for head
    [head_mappings.csv]
2017-07-29 remove debug printf
2017-08-01 new head_mappings.csv from Kyle's measurements
    [head_mappings.csv]
2017-08-02 fix MAJOR bug with FastLED initialization scheme
    [head_mappings.csv]
2017-08-06 head mapping updates from dixon
    [head_mappings.csv]
2017-08-06 initial fixes to head
    [head_mappings.csv]
2017-08-07 finished head mapping
    [head_mappings.csv]
2017-08-07 updated neck indices
    [legs_and_neck_mappings.csv]
2017-08-20 head is done
    [head_mappings.csv]
2017-08-20 legs and neck done
2017-08-20 remove sparkle from legs/neck
